lnls-sirius/usb-rs485-converter/kicad/README

Adjust hole of Mini-USB B
Delete route for LPKF around Sirius logo
