lnls-sirius/usb-rs485-converter/kicad/BOM - Conversor USB-RS485.xls

Designator | Description | Value | PartNumber | Package | Manufacturer | Qtty
C10,C5,C2 | Multilayer Ceramic Capacitor 100nF 100V 5% SMD 0805 X7R | 100nF | 08051C104JAT2A | 0805 | AVX | 3
C3 | Ceramic Capacitor 10nF 50V 5% SMD 0805 C0G | 10nF | GRM2195C1H103JA01D | 0805 | Murata | 1
C6,C4 | Multilayer Ceramic Capacitor 47nF 100V 5% SMD 0805 X7R | 47nF | 08051C473JAT2A | 0805 | AVX | 2
C7 | Multilayer Ceramic Capacitor 10µF 16V ±10% X5R 0805 | 10µF | CL21A106KOQNNNE | 0805 | Samsung | 1
C8,C1 | Multilayer Ceramic Capacitors 4.7µF 50V ±10% X7R 1210 SMD | 4.7µF | GRM32ER71H475KA88L | 1210 | Murata | 2
C9 | Multilayer Ceramic Capacitors SMD/SMT 25V 1uF X7R 0805 5% Tol | 1µF | 08053C105JAT2A | 0805 | AVX | 1
FB1 | Ferrite Bead 40 ohm @100MHz SMD 0805 | 40Ω @ 100 MHz | 875-MI0805K400R-10 | 0805 | Laird-Signal Integrity | 1
Fiducial | Fiducial_1mm_Dia_2 | 54mm_Outer_CopperTop | NA | NA | NA | 1
Fiducial | Fiducial_1mm_Dia_2 | 54mm_Outer_CopperBottom | NA | NA | NA | 1
R1,R3 | Resistor SMD 390 ohm 1% 1/8W 0805 Thick Film | 390Ω | RC0805FR-07390RL | 0805 | Yageo | 2
R2 | Resistor SMD 220 ohm 1% 1/8W 0805 Thick Film | 220Ω | RK73H2ATTD2200F | 0805 | KOA Speer | 1
R5,R4 | Resistor SMD 330 ohm 1% 1/8W 0805 Thick Film | 330Ω | RC0805FR-07330RL | 0805 | Yageo | 2
R7,R6,R8,R9 | Resistor SMD 10K ohm 1% 1/8W 0805 Thick Film | 10kΩ | RC0805FR-0710KL | 0805 | Yageo | 4
U1 | USB Bridge IC, USB to UART Interface | FT232RL-REEL | FT232RL-REEL | SSOP-28 | FTDI | 1
U2 | IC Isolated RS-485 Transceivers | IL3685E | IL3685E | SOIC-16 | NVE Corp/Isolation Products | 1
U3 | IC 1W Isolated, Regulated DC–DC Converter Modules | DCR010505U | DCR010505U/1K | SOIC-28 | Texas Instruments | 1
U4,U5 | 2-channel SPST Analog Switch | TS5A21366 | TS5A21366DCUR | VSSOP-8 | Texas Instruments | 2
