lnls-sirius/usb-rs485-converter/panel/libreCAD/Rear Panel v2.0 (DIP switch).dxf

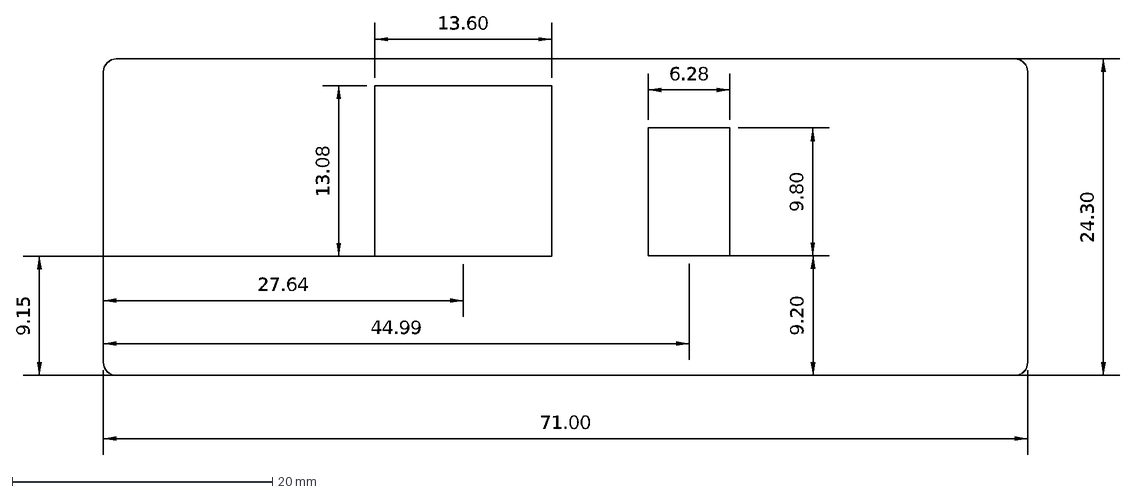
[picture p1: CAD file, 2019-04-09]
panel/libreCAD/Rear Panel v2.0 (DIP switch).dxf
71.00
27.64
13.60
13.08
44.99
9.15
9.20
24.30
9.80
6.28
