lnls-sirius/usb-rs485-converter/panel/libreCAD/Front Panel.dxf

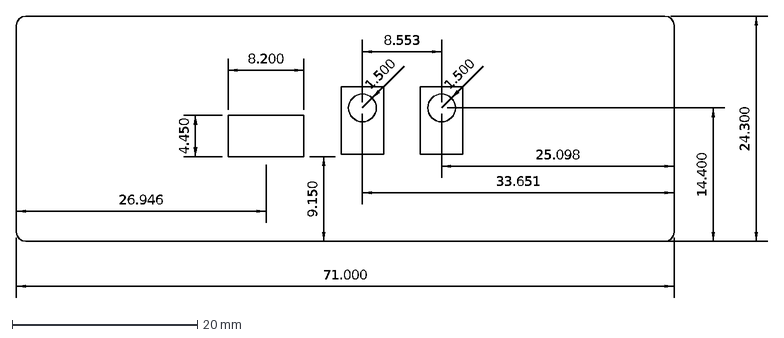
[picture p2: CAD file, 2019-04-09]
panel/libreCAD/Front Panel.dxf
71.000
26.946
8.200
4.450
9.150
24.300
33.651
25.098
8.553
1.500
14.400
