lnls-sirius/usb-rs485-converter/panel/libreCAD/Rear Panel v1.0 (header connector).dxf

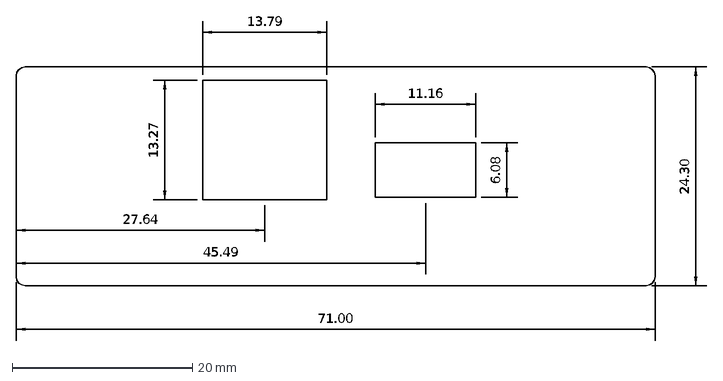
[picture p3: CAD file, 2019-04-09]
panel/libreCAD/Rear Panel v1.0 (header connector).dxf
71.00
24.30
13.79
11.16
13.27
6.08
27.64
45.49
