lnls-sirius/usb-rs485-converter/files/Conversor USB-RS485.pdf

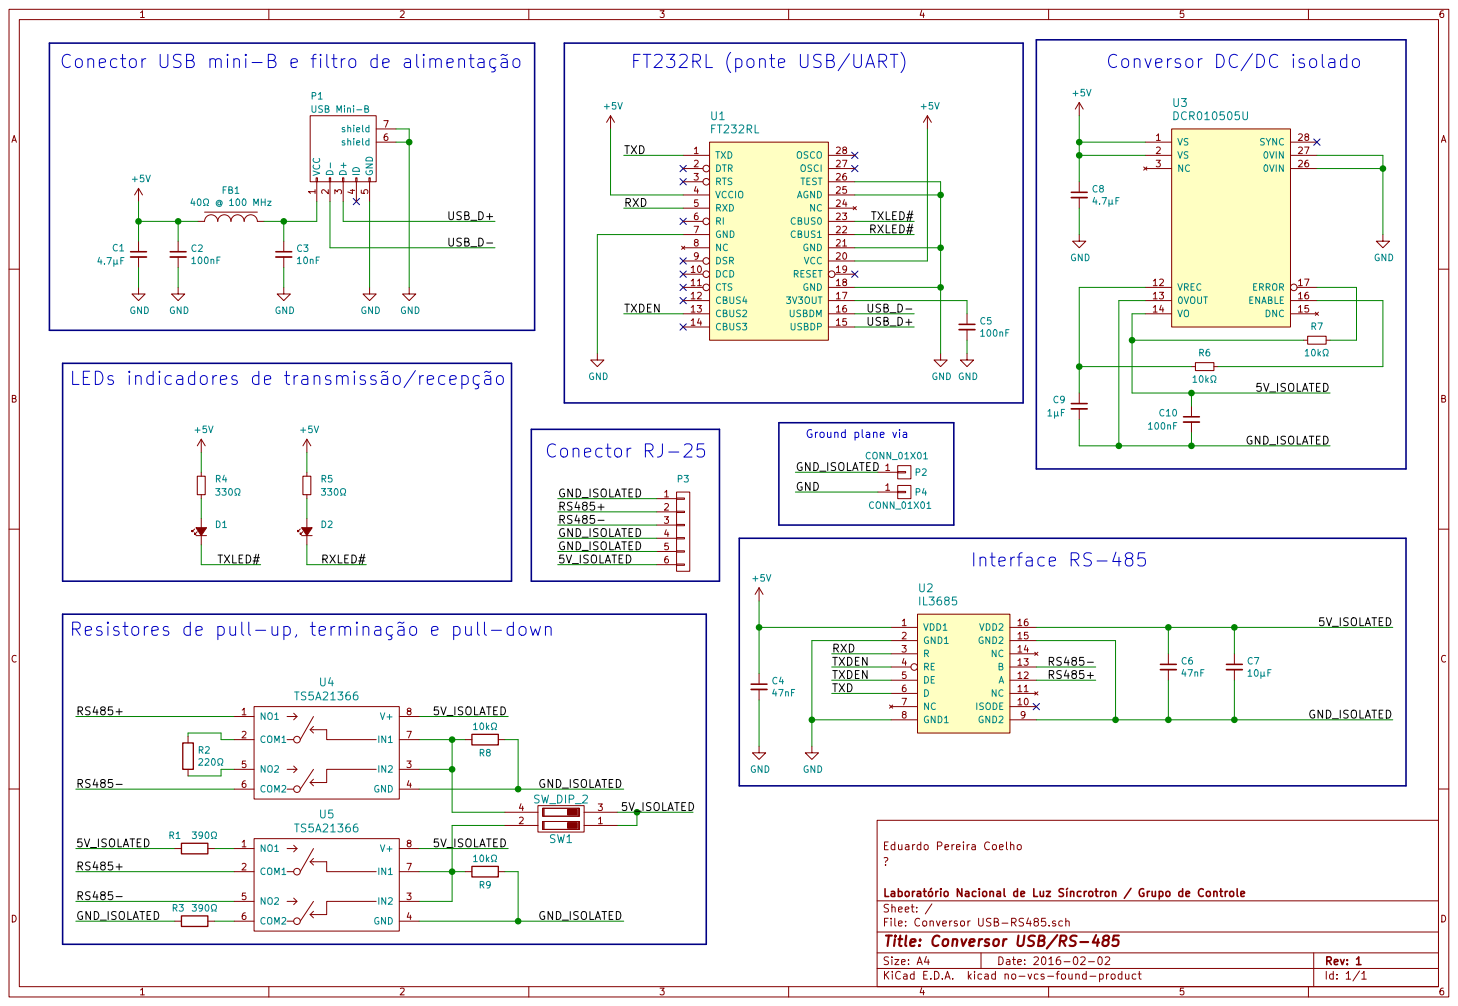
[picture p4: page 1]

Conector USB mini-B e filtro de alimentação

Conversor DC/DC isolado

RXD LEDs indicadores de transmissão/recepção

100nF Resistores de pull-up, terminação e pull-down

TXDEN
TXDEN | 12 B

File: Conversor USB-RS485.sch Sheet: / Laboratório Nacional de Luz Síncrotron / Grupo de Controle

Id: 1/1 Title: Conversor USB/RS-485
