lnls-sirius/usb-rs485-converter/kicad/Conversor USB-RS485.kicad_pcb

## KiCad design kicad/Conversor USB-RS485.kicad_pcb (2019-04-09)

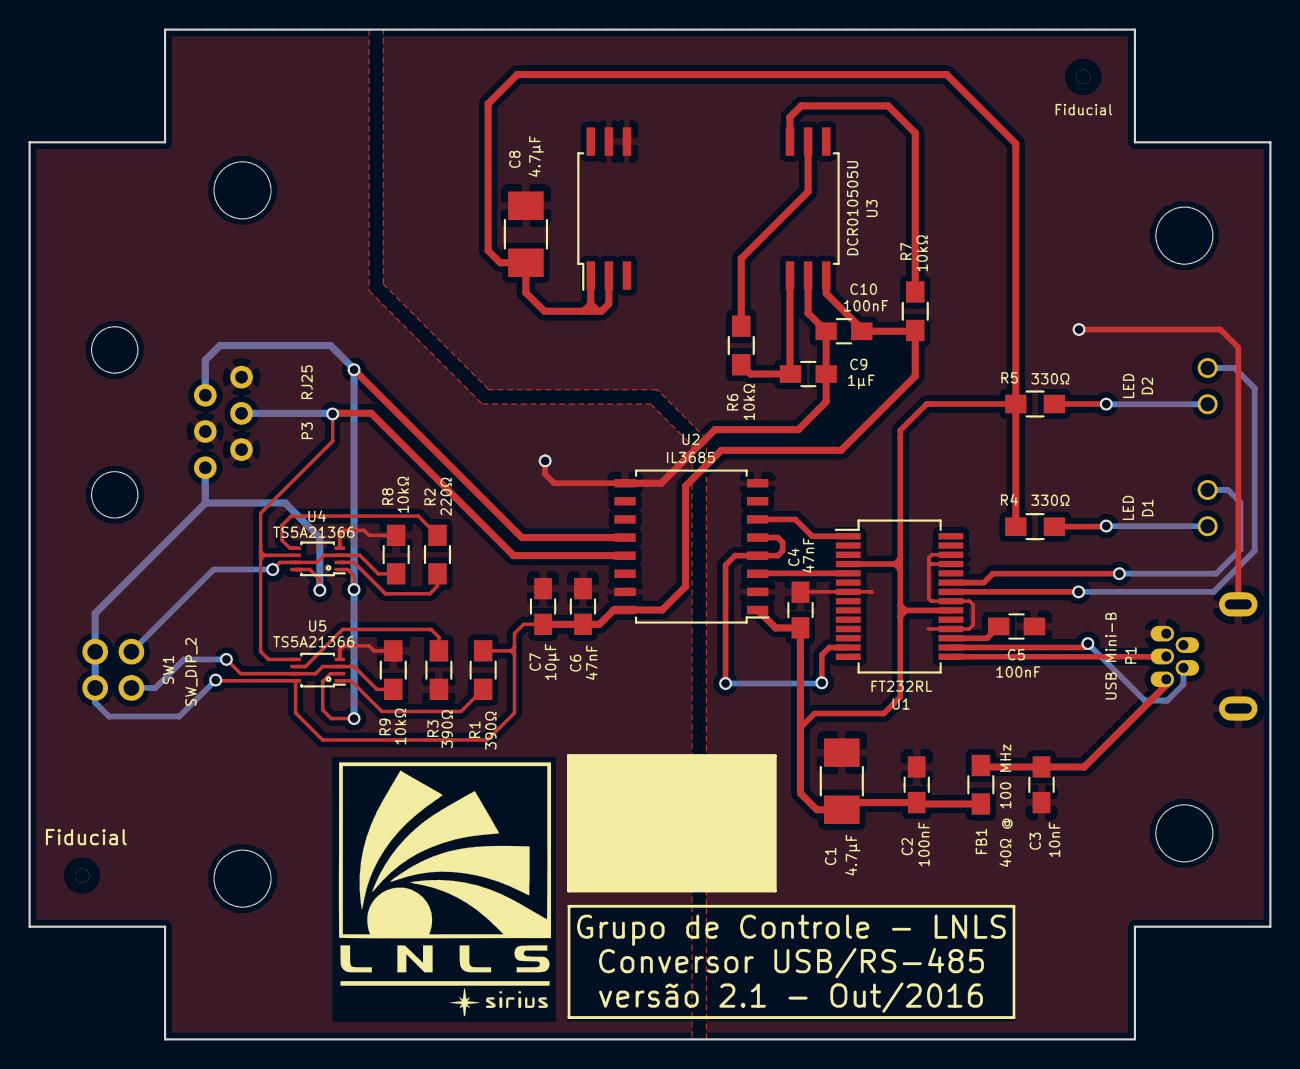
[picture p5: board Conversor USB-RS485.kicad_pcb from above]

Board: 2 copper layers, 87.0 x 70.8 mm, 36 parts (0 on the bottom side), 26 nets.

Parts:
C1, C8: 4.7µF; C_1210_HandSoldering
C2, C5, C10: 100nF; C_0805_HandSoldering
C3: 10nF; C_0805_HandSoldering
C4, C6: 47nF; C_0805_HandSoldering
C7: 10µF; C_0805_HandSoldering
C9: 1µF; C_0805_HandSoldering
D1, D2: LED; LED_para_painel_KINGBRIGHT
F1, F2, F3, F4: Furo de fixação (4mm); MountingHole_4mm
FB1: 40Ω @ 100 MHz; R_0805_HandSoldering
Fiducial: Fiducial_1mm_Dia_2.54mm_Outer_CopperTop
Fiducial#2: Fiducial_1mm_Dia_2.54mm_Outer_CopperBottom
P1: USB Mini-B; USB_Mini-B
P3: RJ25
R1, R3: 390Ω; R_0805_HandSoldering
R2: 220Ω; R_0805_HandSoldering
R4, R5: 330Ω; R_0805_HandSoldering
R6, R7, R8, R9: 10kΩ; R_0805_HandSoldering
SW1: SW_DIP_2; DIP_switch_(2_positions)
U1: FT232RL; SSOP-28_5.3x10.2mm_Pitch0.65mm
U2: IL3685; SOIC-16_7.5x10.3mm_Pitch1.27mm
U3: DCR010505U
U4, U5: TS5A21366; VSSOP-8

Connections:
+5V: C1.1, C2.1, C4.1, C8.1, FB1.1, R4.1, R5.1, U1.4, U1.20, U2.1, U3.1, U3.2
/5V_ISOLATED: C6.1, C7.1, C10.1, P3.6, R1.2, R7.1, SW1.1, SW1.3, U2.16, U3.14, U4.8, U5.8
/GND_ISOLATED: C6.2, C7.2, C9.2, C10.2, P3.1, P3.4, P3.5, R3.2, R8.1, R9.1, U2.9, U2.15, U3.13, U4.4, U5.4
/RS485+: P3.2, U2.12, U4.1, U5.2
/RS485-: P3.3, U2.13, U4.6, U5.5
/RXD: U1.5, U2.3
/RXLED#: D2.1, U1.22
/TXD: U1.1, U2.6
/TXDEN: U1.13, U2.4, U2.5
/TXLED#: D1.1, U1.23
/USB_D+: P1.3, U1.15
/USB_D-: P1.2, U1.16
GND: C1.2, C2.2, C3.2, C4.2, C5.2, C8.2, P1.5, P1.6, P1.7, U1.7, U1.18, U1.21, U1.25, U1.26, U2.2, U2.8, U3.26, U3.27
unnamed: C3.1, FB1.2, P1.1
unnamed: C5.1, U1.17
unnamed: C9.1, R6.1, U3.12
unnamed: D1.2, R4.2
unnamed: D2.2, R5.2
unnamed: R1.1, U5.1
unnamed: R2.1, U4.2
unnamed: R2.2, U4.5
unnamed: R3.1, U5.6
unnamed: R6.2, U3.16
unnamed: R7.2, U3.17
unnamed: R8.2, SW1.4, U4.3, U4.7
unnamed: R9.2, SW1.2, U5.3, U5.7
